raffaelerasini/stand-generator/README.md

# Supporti inclinabili low profile

Un solo generatore (`stand.py`) per tre strumenti. Tutti hanno la stessa struttura a sdraio, ma con la **cerniera a pochi millimetri dal tavolo**:

- 2 fianchi, ognuno fatto di **base** con tacche a gradini, **ripiano** incernierato con bordino anteriore e **asta** che ruota in una forcella sul retro del ripiano;
- 2 traverse (una al centro, una dietro) che passano in tunnel nelle pareti della base e si fissano con una vite nell'aletta interna; le asole regolano la distanza tra i fianchi.

Davanti non c'è nessun blocco: la cerniera ha tutto lo spazio per ruotare.

| Cartella | Strumento | Angoli | Piano d'appoggio davanti | Profondità base | Filamento |
|---|---|---|---|---|---|
| `virus_ti/` | Access Virus TI/TI2 Desktop, 470 × 188 × 81 mm, 3,5 kg | 15° 25° 35° 45° | **22 mm** (bordino +30) | **190 mm** | ~460 g |
| `tracker_plus/` | Polyend Tracker+, 282 × 207 × 33 mm, 1,2 kg | 5° 10° 15° | **18 mm** (bordino +10) | 228 mm | ~255 g |
| `launchpad_pro/` | Novation Launchpad Pro MK3, 268 × 268 × 18 mm, ~1 kg | 5° 10° 15° | **18 mm** (bordino +8) | 228 mm | ~255 g |

Per confronto, nella prima versione (`../virus_stand/`) il piano d'appoggio era a 66 mm.
In ogni configurazione ho verificato che non ci siano collisioni tra base, ripiano, asta, traverse, teste delle viti e strumento (booleane 3D), e che ogni pezzo sia un corpo unico.
La traversa centrale si posiziona da sola: la vecchia posizione (x = 40–45) toccava il ripiano all'angolo minimo, e il controllo vecchio non lo vedeva.
A 45° il bordo anteriore-alto del Virus sporge ~60 mm davanti alla base (in aria): è normale, la base resta entro i 190 mm.

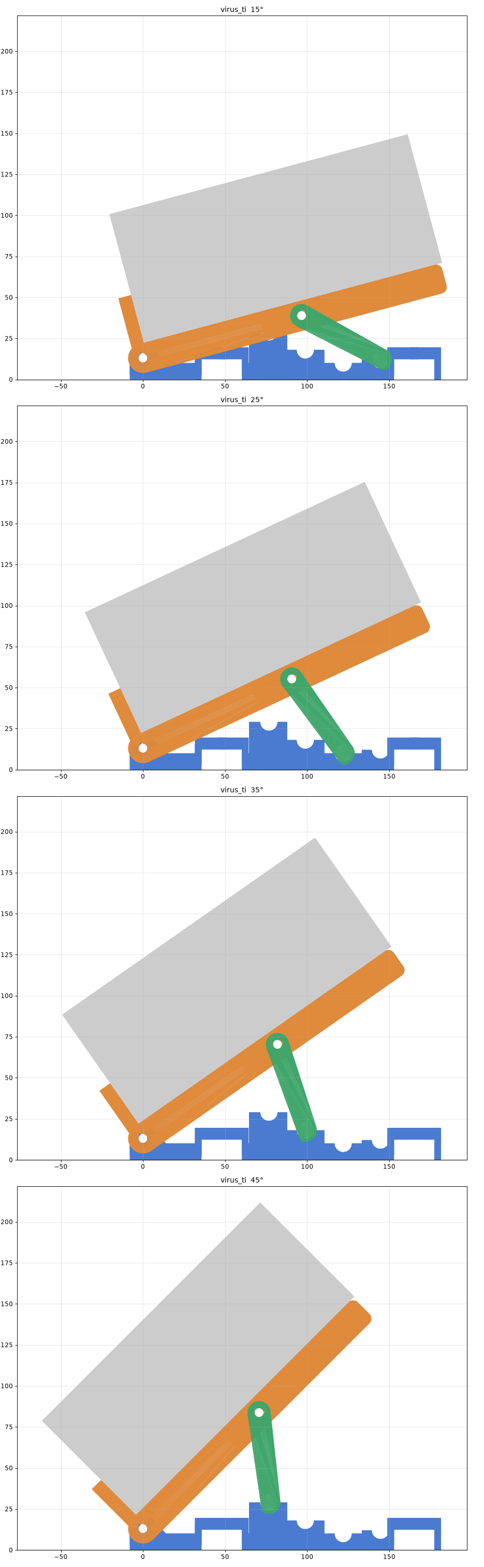
[picture p1: virus_ti/preview/vista_laterale.png]
virus


## Pezzi (`<strumento>/stl/`, già orientati per la stampa, senza supporti)

| | Virus TI | Tracker+ / Launchpad |
|---|---|---|
| `base_x2` | 190 × 72 × 29 | 228 × 72 × 18 |
| `deck_x2` (ripiano) | 199 × 27 × 34 | 197 × 27 × 22–24 |
| `prop_x2` (asta) | 69 × 41 × 14 | 47 × 40 × 12 |
| traverse | `crossbar_A_x2` + `crossbar_B_x2` (244 mm, unite a mezzo legno) | `crossbar_x2` (248 mm, in un pezzo) |

Le traverse sono lunghe 244–248 mm: nel piatto da 256 della A1 entrano di poco; se lo slicer si lamenta, ruotale in diagonale.
Stampa consigliata: PETG, 4 pareti, gyroid 30–40 %.

## Ferramenta

Le viti di cerniera e perno possono essere a brugola (DIN 912) o a testa esagonale (DIN 933): ho verificato che le teste non tocchino le pareti a nessun angolo.

**Virus TI**

- 2 viti M5×50 per la cerniera (l'autobloccante va nella sede esagonale della parete)
- 2 viti M5×40 per il perno dell'asta
- 4 dadi autobloccanti M5 e 6 rondelle
- 4 viti M5×20, 4 dadi e 4 rondelle per fissare le traverse (nell'aletta interna delle basi)
- 6 viti M5×16 e 6 dadi per la giunzione delle traverse (3 per traversa)

**Tracker+ e Launchpad Pro (per ciascuno)**

- 2 viti M5×50 per la cerniera (l'autobloccante va nella sede esagonale della parete)
- 2 viti M5×40 per il perno dell'asta
- 4 dadi autobloccanti M5 e 6 rondelle
- 4 viti M5×16, 4 dadi e 4 rondelle per le traverse (nell'aletta interna delle basi)

## Montaggio

Ogni cartella ha `istruzioni.pdf`: istruzioni illustrate stile IKEA (pezzi, ferramenta in scala 1:1, passi esplosi, cambio angolo). In breve:

1. **Traverse.** Sul Virus, unisci le metà A e B nella zona a mezzo legno: i dadi vanno nelle sedi esagonali sotto A, le teste delle viti nelle lamature sopra B.
2. **Basi.** Infila le due traverse nei tunnel delle basi (quello al centro e quello dietro). Le alette con il foro rivolte verso l'interno ricevono la vite: dado nel canale sotto la traversa, vite con rondella dall'alto. Le asole regolano la distanza tra i fianchi:
   - Virus: 330–390 mm, consigliata ~370;
   - Tracker+: 170–200 mm, consigliata ~190;
   - Launchpad Pro: 160–200 mm, consigliata ~180.
3. **Ripiano.** Infilalo tra le pareti della base, davanti, e fissalo con la vite della cerniera (rondella sotto la testa) e il dado autobloccante, che va incassato nella sede esagonale sul lato esterno della parete.
4. **Asta.** Inseriscila nella forcella sul retro del ripiano e fissala con il perno. Le "orecchie" del piede si appoggiano nelle tacche delle pareti.
5. **Cambio angolo.** Solleva il retro dello strumento, sposta il piede nella tacca voluta e riabbassa. Le tacche sono a gradini: la più bassa e più indietro è l'angolo minimo, la più alta e più avanti è il massimo.

## Rigenerare / modificare

Il motore è il pacchetto `standgen/`, lo stesso che usa il sito:

| File | Cosa fa |
|---|---|
| `model.py` | parametri (default leggero/pesante, `PRESETS`) e geometria, nella classe `Stand` |
| `tune.py` | calcolo automatico di tacche, perno e lunghezza dell'asta (minimizza la profondità) |
| `checks.py` | verifica: collisioni a ogni angolo (anche ripiano/asta contro le traverse), pezzi interi, piatto, viti, tacche, stabilità, scorta |
| `hardware.py` | catalogo della viteria standard (`../VITERIA_STANDARD.md`) e scelta delle lunghezze |
| `render.py` | anteprime PNG e assemblato 3D colorato (GLB) |
| `drawing.py` | disegni al tratto: rasterizzatore z-buffer in numpy, contorni senza linee nascoste, viteria 3D |
| `blueprint.py` | per il sito: disegni chiari su fondo trasparente e mesh con spigoli vivi per il visore |
| `ikea.py` | `istruzioni.pdf`: copertina, pezzi, ferramenta 1:1, passi esplosi con dettagli, cambio angolo |
| `pipeline.py` | `generate(parametri, cartella)`: STL, anteprime, `ferramenta.csv`, `verifica.md`, `montaggio.md`, `parametri.json`, zip |

```
python stand.py                          # tutti i profili (o: python stand.py virus_ti)
python stand.py --params mio.json        # strumento nuovo: le tacche si calcolano se mancano
python stand.py --no-pdf                 # senza istruzioni illustrate (~15-20 s per strumento)
python render.py                         # solo anteprime
python tests/test_engine.py              # test
```

Un file di parametri minimo per uno strumento nuovo:

```json
{"DEV_W": 378, "DEV_D": 293, "DEV_H": 41, "DEV_KG": 3.2, "ANGLES": [10, 20, 30], "MAX_DEPTH": 200}
```

Da 2 kg in su si usano automaticamente i pezzi robusti (come il Virus).

`PRESETS` contiene anche i desktop synth, le groovebox e i controller più diffusi (scelti dalle vetrine Thomann e
dalle guide 2026), con le misure delle schede dei produttori: Korg volca, Roland AIRA Compact, Behringer TD-3,
Model D e UB-Xa D, Moog Mother-32, Waldorf Blofeld, Korg minilogue xd module; Elektron Digitakt II / Digitone II /
Syntakt, Roland TR-8S, SP-404MKII e MC-707, Akai MPC One+ e Live III, Novation Circuit, Teenage Engineering EP-133,
Maschine+; Launchpad X e Mini MK3, Launch Control XL 3, Akai APC40 MKII, APC mini MK2 e MPD218, Maschine Mikro MK3
e MK3, Ableton Push 3, Arturia BeatStep Pro. I synth sono a 10°, 20° e 30°, controller e groovebox a 5°, 10° e 15°.

Ci sono poi i computer Commodore con tastiera integrata: VIC-20, C64 (breadbin),
C64C, C16, Plus/4, C128, Amiga 500 / 500 Plus, Amiga 600, Amiga 1200, tutti a 5°, 10° e 15°. Le misure vengono da
c64-wiki.de, Wikipedia e dalle brochure Commodore e differiscono di qualche millimetro tra le fonti: prima di
stampare misura il tuo. Il peso di C16 e Plus/4 non si trova ed è stimato per eccesso. Gli Amiga con tastiera
separata (1000, 2000, 3000, 4000) non ci sono: non hanno una tastiera da inclinare.

Altri home computer, sempre a 5°, 10° e 15°: Sinclair ZX Spectrum 16K/48K, Spectrum+ / 128, +2 / +3; Atari 800,
600XL, 800XL, 520ST (cassa corta), 520/1040 STF e STE; Amstrad CPC 464, 664, 6128; Acorn BBC Micro Model B;
Texas Instruments TI-99/4A. Le fonti sono musei e archivi di appassionati (vedi i commenti in `model.py`); le misure
più incerte sono quelle dello Spectrum +2 / +3. Peso stimato per eccesso per Spectrum+ e CPC 6128.

## Sito web: STAND

Interfaccia in HTML, CSS e JavaScript semplici (`static/`, nessun framework né build) sopra un'API FastAPI (`app.py`).
Stile "blueprint scuro": fondo grafite millimetrato, tratto chiaro, un solo accento arancio; caratteri Space Grotesk,
Inter e JetBrains Mono da Google Fonts.

- **Modello:** visore 3D fatto in casa in WebGL2 (ortografico come un disegno tecnico: trascina per ruotare, rotella
  per lo zoom, tasto destro per spostare, doppio clic per tornare alla vista iniziale) oppure profilo per ogni angolo;
  riepilogo con misure, pezzi, ferramenta e download.
- **Pezzi e ferramenta:** disegni dei pezzi, viti in proporzione, quantità e scorta.
- **Montaggio:** le pagine di `istruzioni.pdf` con testo e ferramenta di ogni passo (il PDF si crea al primo clic, ~20 s).
- **Verifica:** tutti i controlli, raggruppati.

Ogni risultato ha un indirizzo (`#/<chiave>/<scheda>`) che si può riaprire finché resta in cache
(`DATA_DIR/cache`, ultime `CACHE_MAX` generazioni).

| API | |
|---|---|
| `GET /api/presets` | profili pronti |
| `POST /api/generate` | genera (o riprende dalla cache): `{key}` oppure un lavoro `{id, state, progress, stage}` |
| `GET /api/jobs/{id}` | avanzamento del lavoro |
| `GET /api/result/{key}` | riepilogo, pezzi, ferramenta, controlli, guida al montaggio |
| `POST /api/pdf/{key}` | crea le istruzioni illustrate |
| `GET /api/mesh/{key}/{angolo}.json` | mesh per il visore (vertici, triangoli, spigoli vivi) |
| `GET /api/draw/{key}/{hero,side_<angolo>,part_<pezzo>}.png` | disegni blueprint, creati alla prima richiesta |
| `GET /files/{key}/…` | STL, zip, CSV, PDF |

```
pip install -r requirements.txt && python app.py      # http://localhost:7860
docker compose up --build                             # idem, in container (porta dal file override)
```

**Coolify:** nuova risorsa *Docker Compose* dal repository (cartella base `/`, file `docker-compose.yml`);
assegna il dominio al servizio `stands` (porta 7860). Variabili facoltative: `APP_PASSWORD` (+ `APP_USER`, default
`admin`) per proteggere il sito, `CONCURRENCY` (generazioni in parallelo, default 2), `CACHE_MAX`.
I risultati stanno nel volume `stands-data`. `docker-compose.override.yml` serve solo in locale (pubblica la porta).
