raffaelerasini/stand-generator/tracker_plus/istruzioni.pdf

# Supporto inclinabile

## Polyend Tracker+

5° 10° 15°

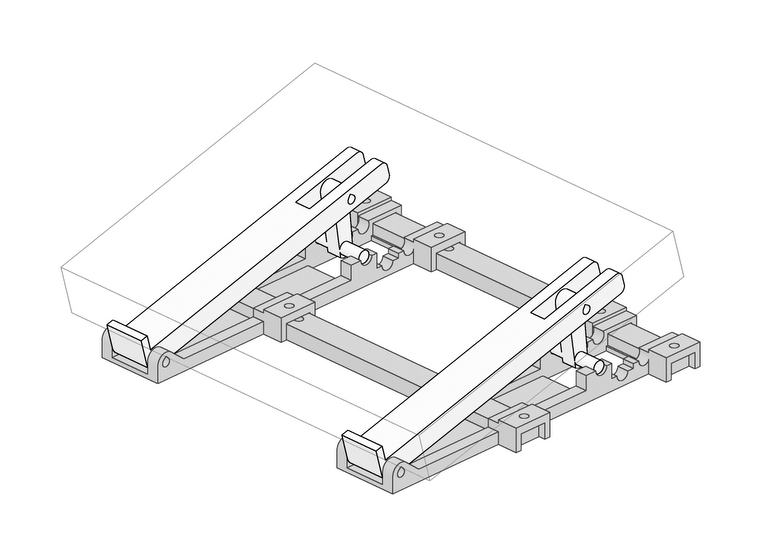
[picture p9: figure]

# Ti servono

### - chiave a brugola 4 mm

### - chiave fissa o a tubo da 8 mm

Stampa i pezzi in PETG, 4 pareti, riempimento gyroid 30–40 %, senza supporti.

Le viti sono tutte M5 inox della scorta standard.

# Pezzi da stampare

2×

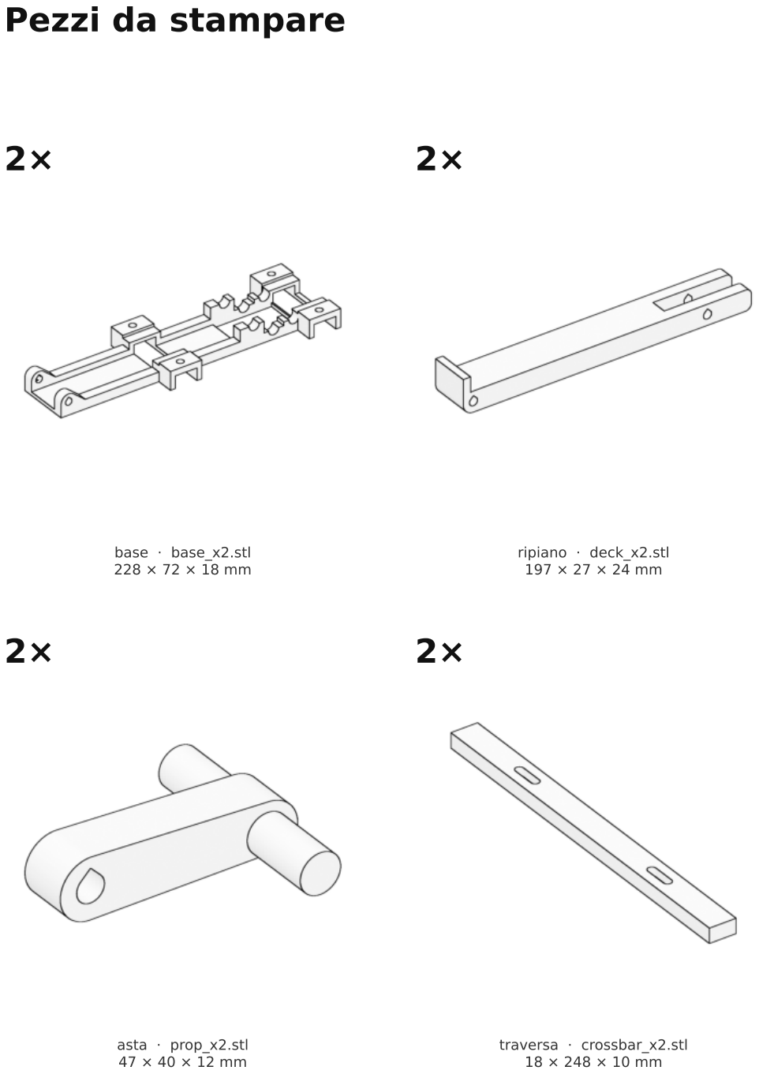
[picture p10: page 2]

base · base_x2.stl
228 × 72 × 18 mm

2×

ripiano · deck_x2.stl
197 × 27 × 24 mm
2×

asta · prop_x2.stl
47 × 40 × 12 mm

2×

traversa · crossbar_x2.stl 18 × 248 × 10 mm

# Ferramenta

Scala 1:1: stampa al 100 % e appoggia le viti sul disegno per riconoscerle.

2× | Vite M5×50 testa esagonale (DIN 933)
| cerniera
4× | Dado M5 autobloccante
| cerniera, perno asta
2× | Vite M5×40 testa esagonale (DIN 933)
| perno asta
10× | Rondella M5 5×10
| cerniera, perno asta, traverse
4× | Vite M5×16 brugola (DIN 912)
| traverse
4× | Dado M5
| traverse

controllo scala: 100 mm

1

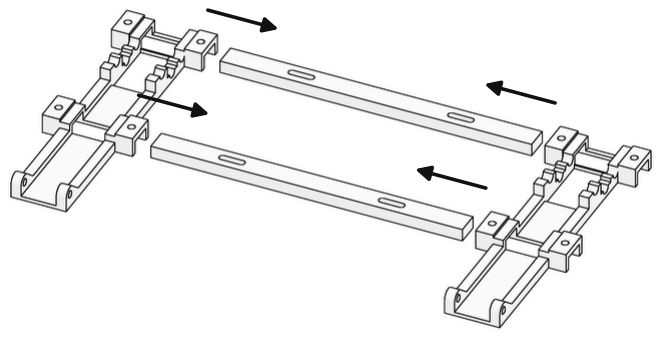
[picture p11: figure]

Infila le traverse nei tunnel delle due basi, una davanti e una dietro (sono uguali). Le alette con il foro restano

verso l'interno.

2

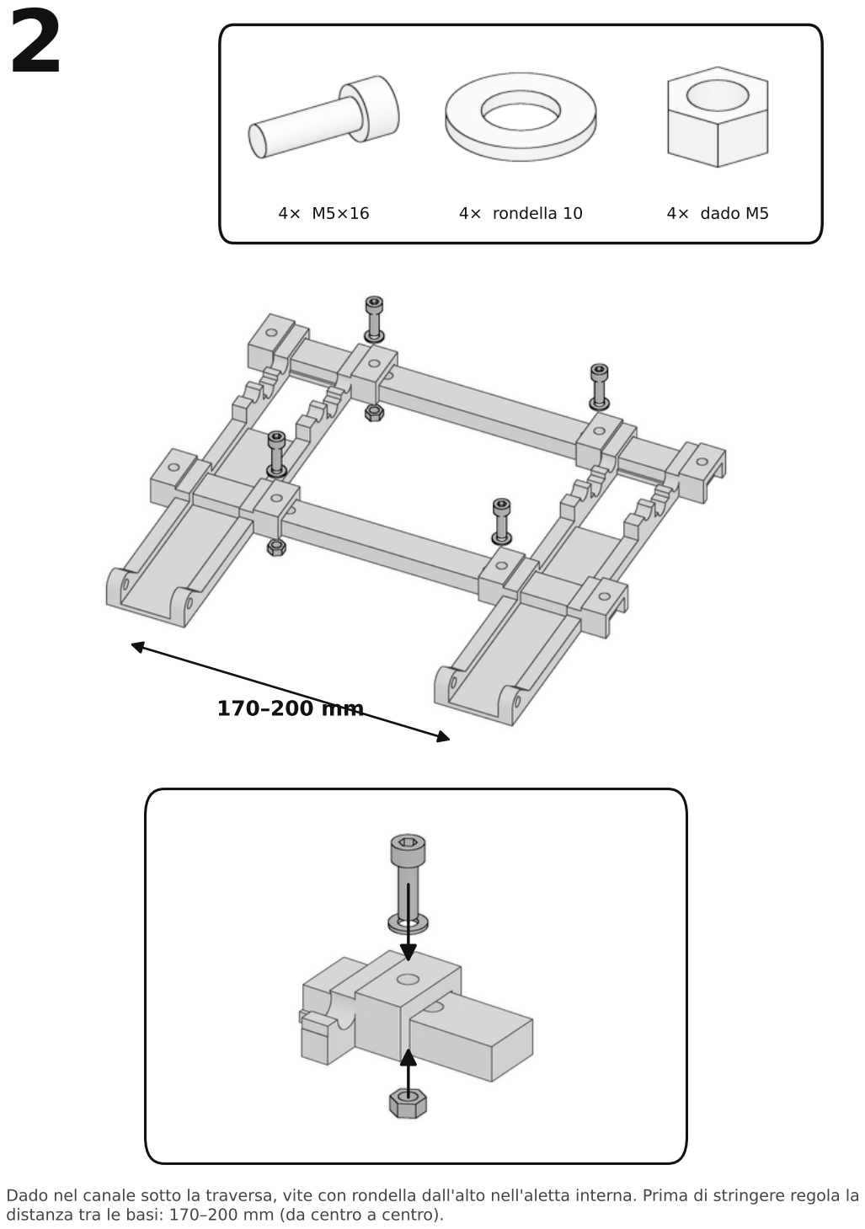
[picture p12: page 5]

170–200 mm

Dado nel canale sotto la traversa, vite con rondella dall'alto nell'aletta interna. Prima di stringere regola la distanza tra le basi: 170–200 mm (da centro a centro).

4× M5×16 | 4× rondella 10 | 4× dado M5

3

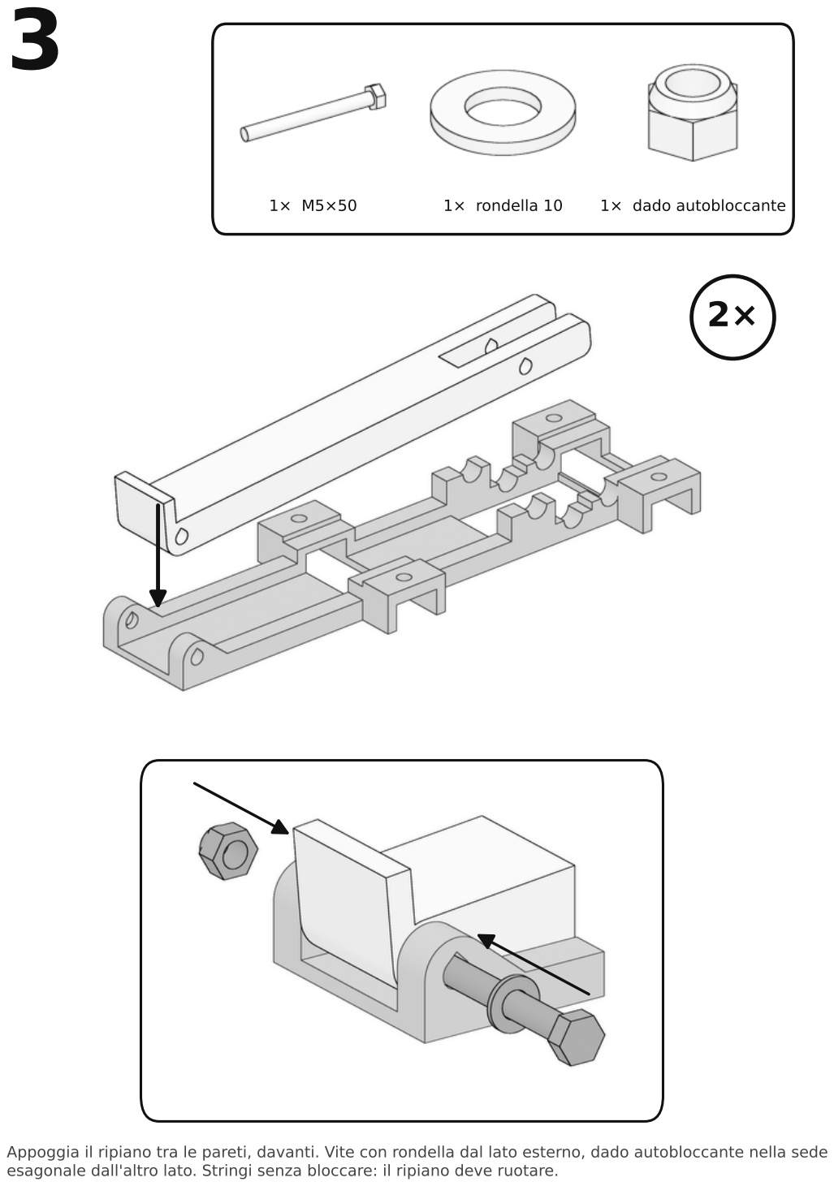
[picture p13: page 6]

Appoggia il ripiano tra le pareti, davanti. Vite con rondella dal lato esterno, dado autobloccante nella sede esagonale dall'altro lato. Stringi senza bloccare: il ripiano deve ruotare.

1× M5×50 | 1× rondella 10 | 1× dado autobloccante
2×

4

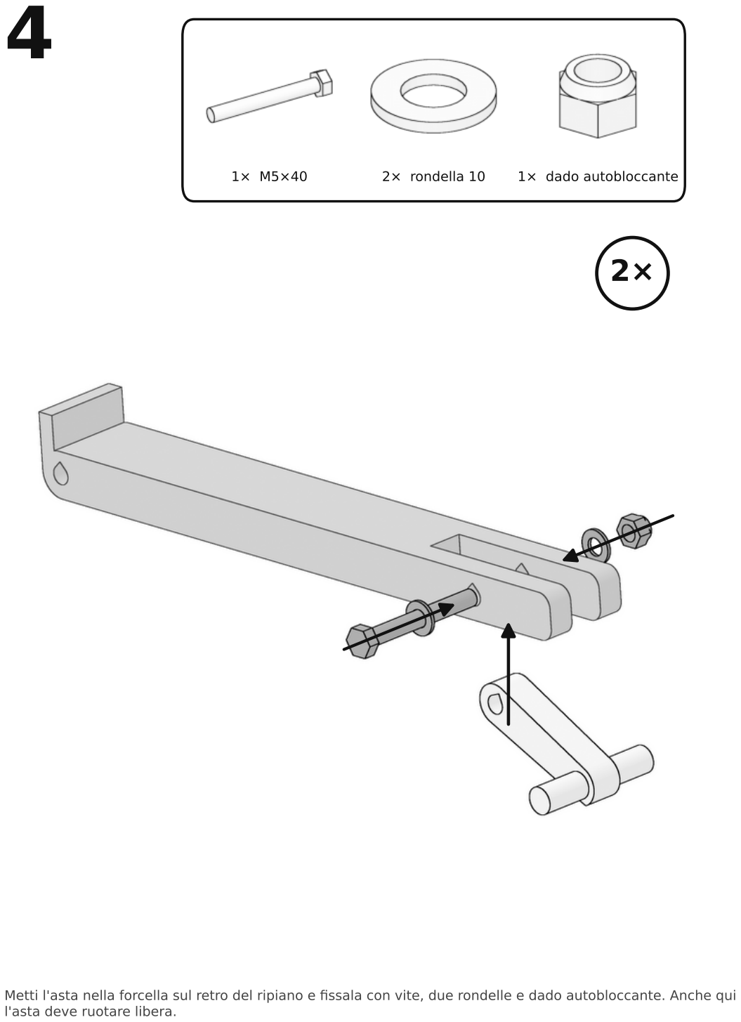
[picture p14: page 7]

Metti l'asta nella forcella sul retro del ripiano e fissala con vite, due rondelle e dado autobloccante. Anche qui

l'asta deve ruotare libera.

1× M5×40 | 2× rondella 10 | 1× dado autobloccante
2×

5

5°

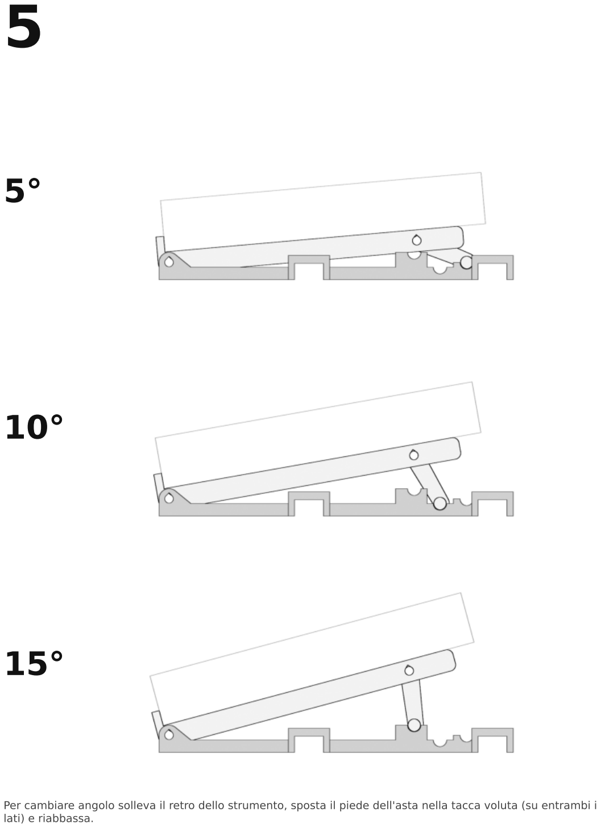
[picture p15: page 8]

Per cambiare angolo solleva il retro dello strumento, sposta il piede dell'asta nella tacca voluta (su entrambi i lati) e riabbassa.

10°

15°
