raffaelerasini/stand-generator/virus_ti/istruzioni.pdf

# Supporto inclinabile

## Access Virus TI/TI2 Desktop

15° 25° 35° 45°

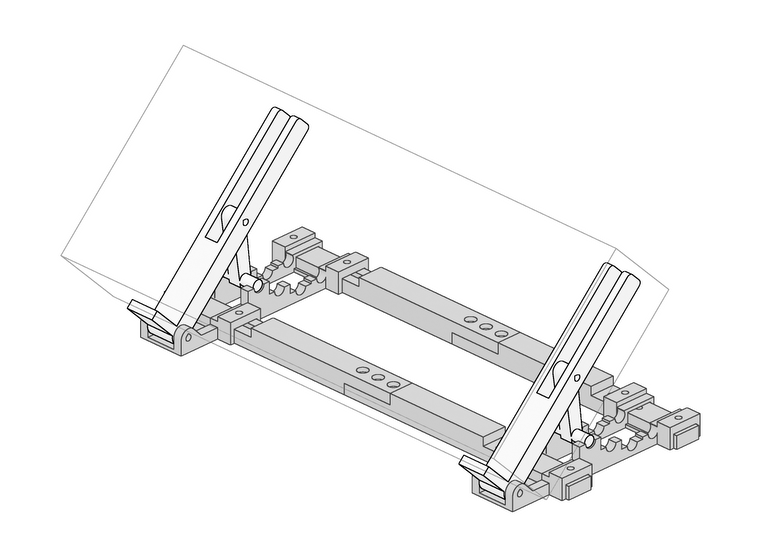
[picture p16: figure]

## Ti servono

### - chiave a brugola 4 mm

### - chiave fissa o a tubo da 8 mm

Stampa i pezzi in PETG, 4 pareti, riempimento gyroid 30–40 %, senza supporti.

Le viti sono tutte M5 inox della scorta standard.

# Pezzi da stampare

2×

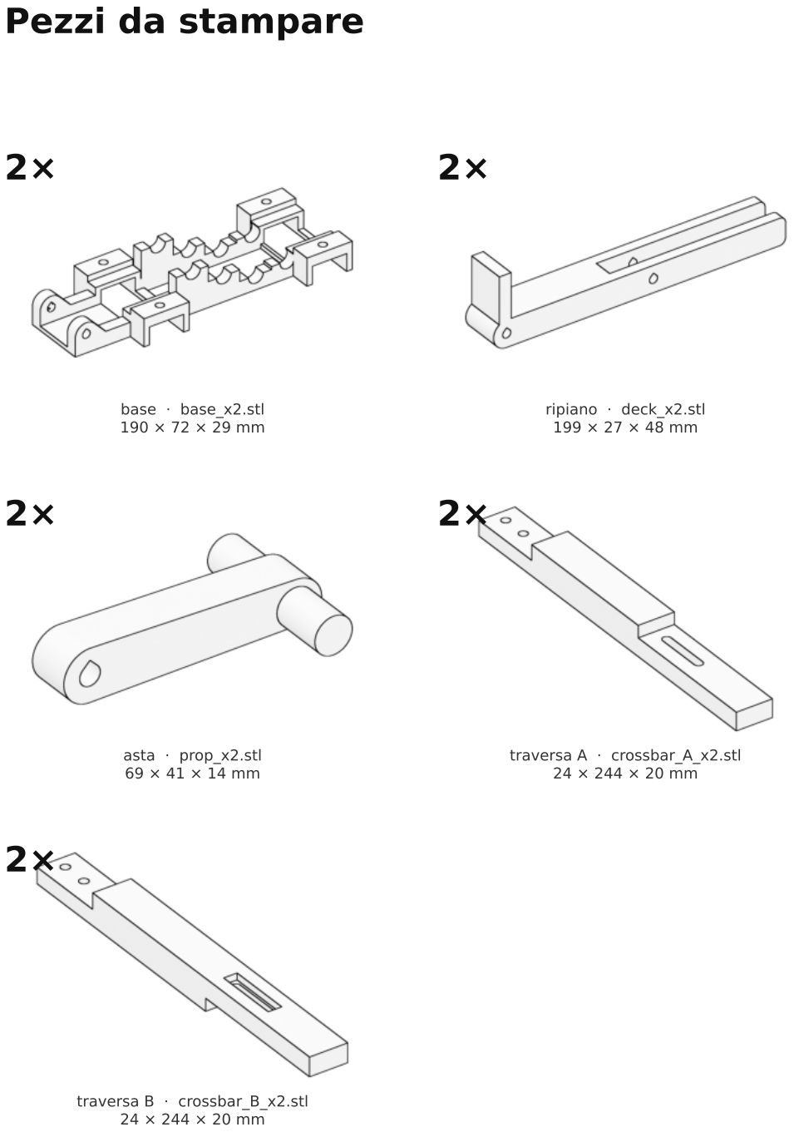
[picture p17: page 2]

base · base_x2.stl
190 × 72 × 29 mm

2×

ripiano · deck_x2.stl
199 × 27 × 48 mm

2×

asta · prop_x2.stl
69 × 41 × 14 mm

2×

traversa A · crossbar_A_x2.stl 24 × 244 × 20 mm

2×

traversa B · crossbar_B_x2.stl 24 × 244 × 20 mm

# Ferramenta

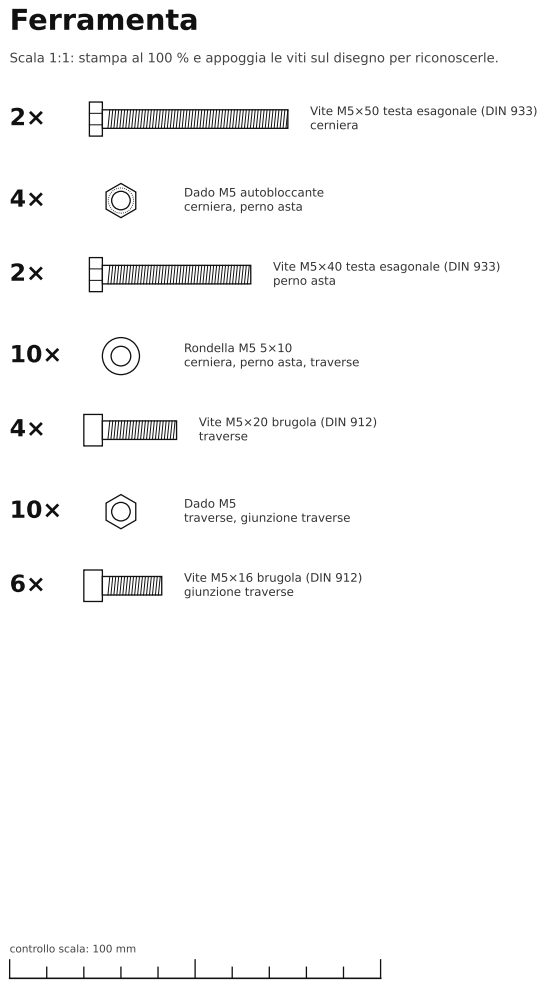
[picture p18: page 3]
Vite M5×50 testa esagonale (DIN 933); cerniera; Dado M5 autobloccante; Vite M5×40 testa esagonale (DIN 933); perno asta; Rondella M5 5×10; Vite M5×20 brugola (DIN 912); traverse; Dado M5; Vite M5×16 brugola (DIN 912); giunzione traverse

Scala 1:1: stampa al 100 % e appoggia le viti sul disegno per riconoscerle.

cerniera, perno asta

cerniera, perno asta, traverse

traverse, giunzione traverse

controllo scala: 100 mm

1

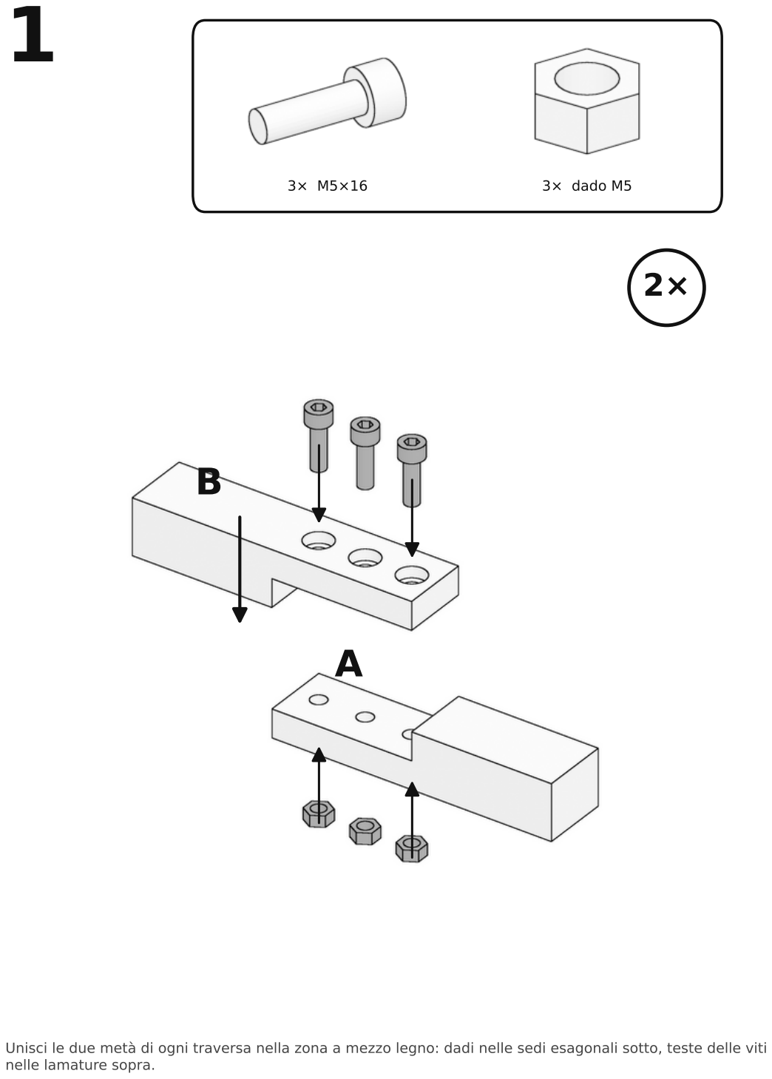
[picture p19: page 4]

A

B

Unisci le due metà di ogni traversa nella zona a mezzo legno: dadi nelle sedi esagonali sotto, teste delle viti nelle lamature sopra.

3× M5×16 | 3× dado M5

2×

2

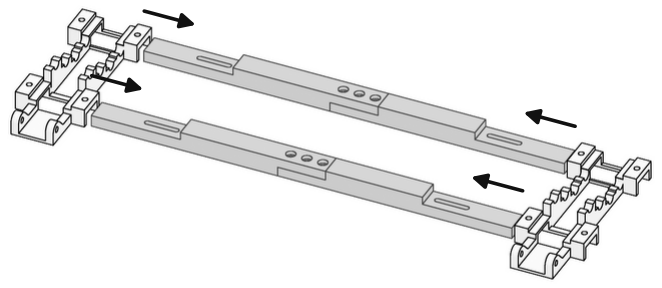
[picture p20: figure]

Infila le traverse nei tunnel delle due basi, una davanti e una dietro (sono uguali). Le alette con il foro restano

verso l'interno.

3

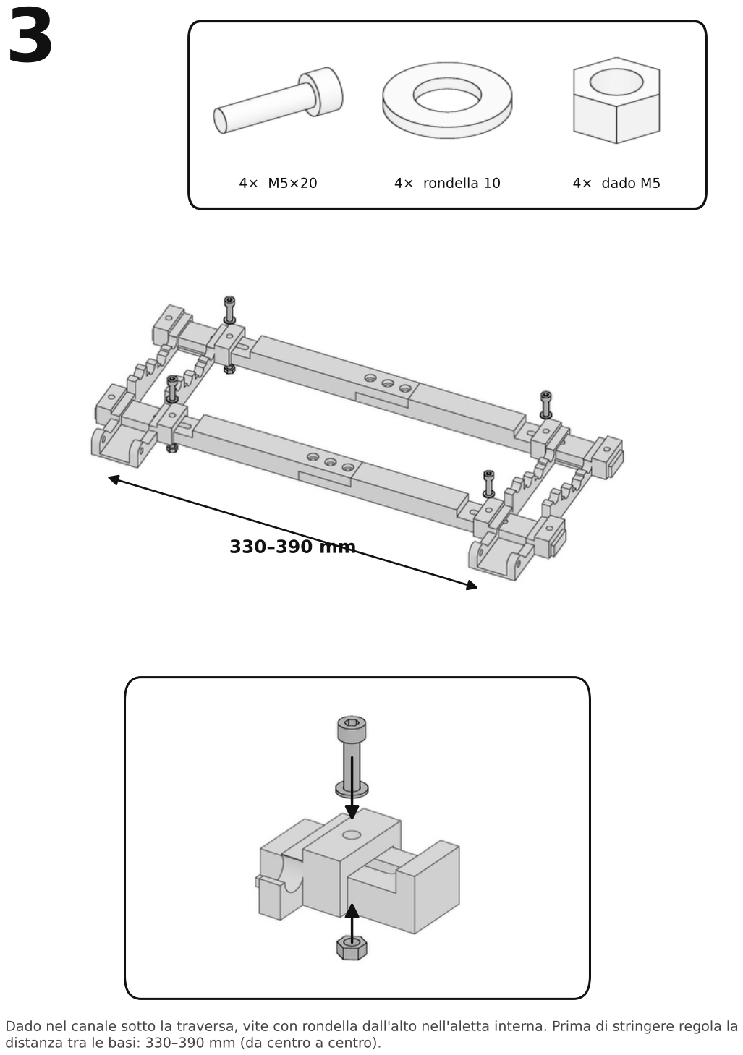
[picture p21: page 6]

330–390 mm

Dado nel canale sotto la traversa, vite con rondella dall'alto nell'aletta interna. Prima di stringere regola la distanza tra le basi: 330–390 mm (da centro a centro).

4× M5×20 | 4× rondella 10 | 4× dado M5

4

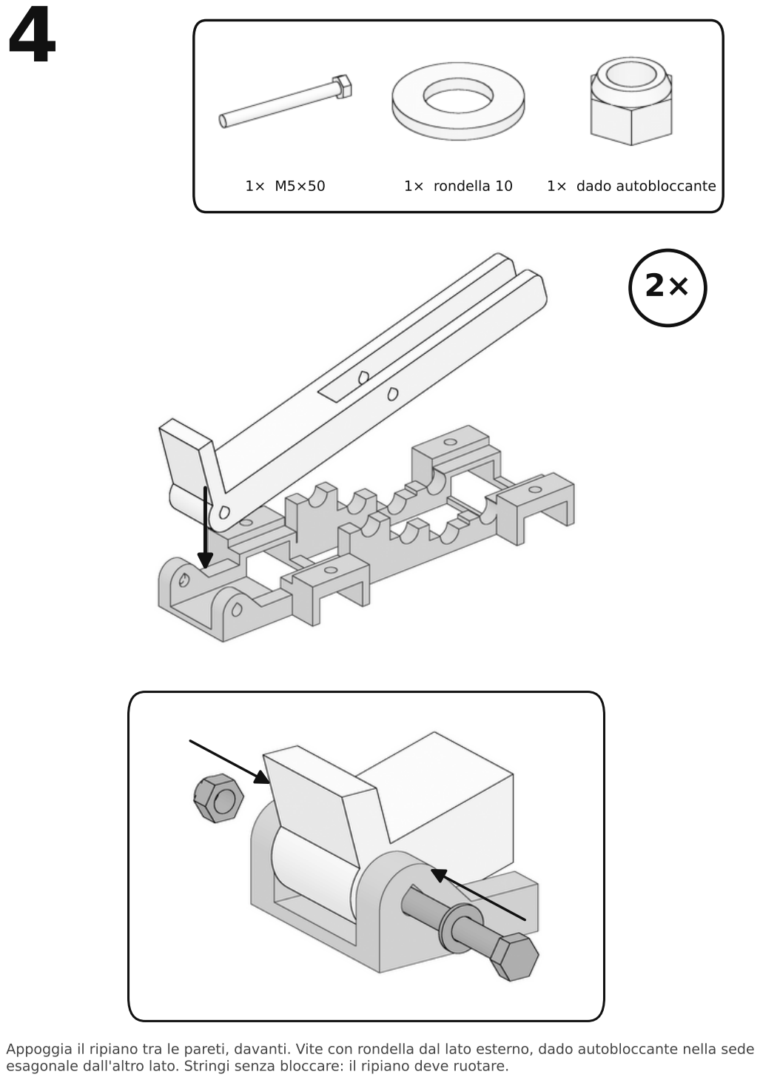
[picture p22: page 7]

Appoggia il ripiano tra le pareti, davanti. Vite con rondella dal lato esterno, dado autobloccante nella sede esagonale dall'altro lato. Stringi senza bloccare: il ripiano deve ruotare.

1× M5×50 | 1× rondella 10 | 1× dado autobloccante

2×

5

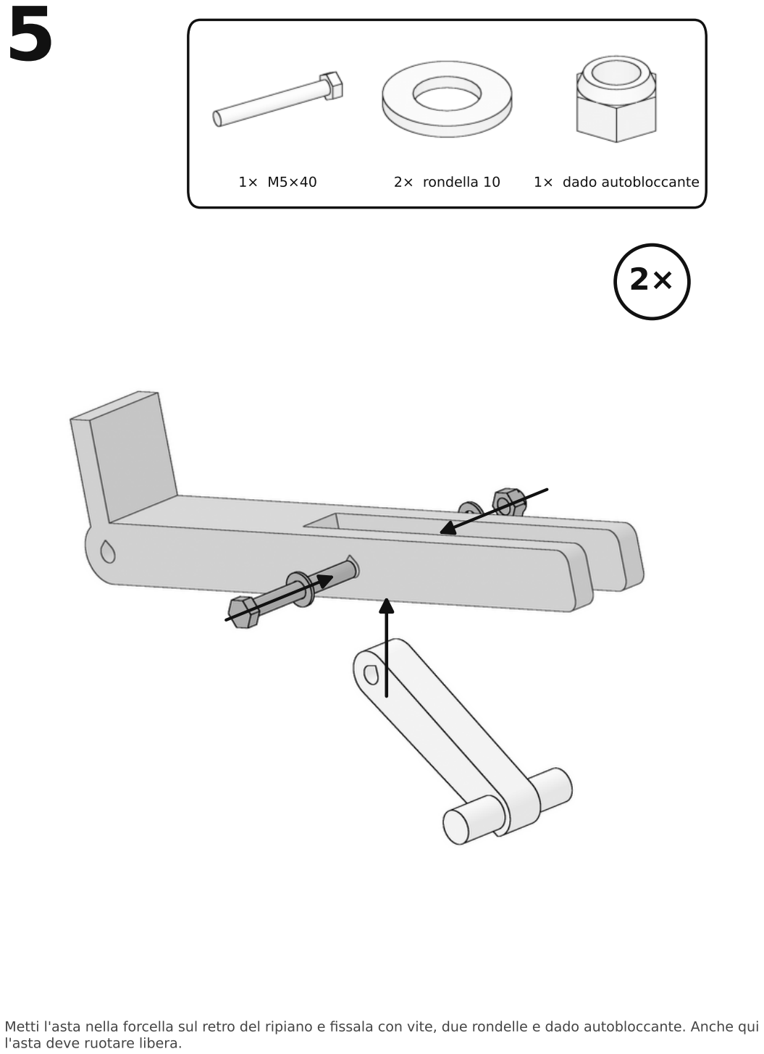
[picture p23: page 8]

Metti l'asta nella forcella sul retro del ripiano e fissala con vite, due rondelle e dado autobloccante. Anche qui

l'asta deve ruotare libera.

1× M5×40 | 2× rondella 10 | 1× dado autobloccante

2×

6

15°

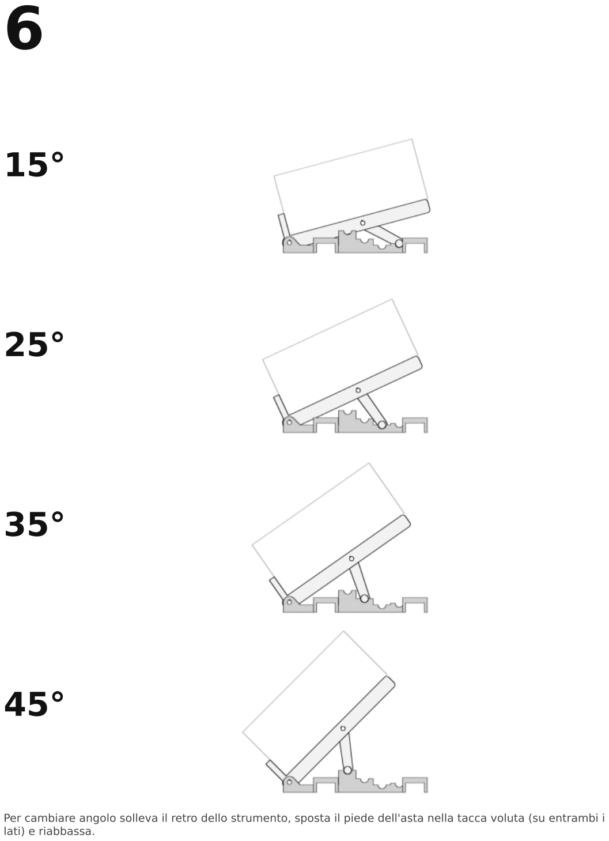
[picture p24: page 9]

Per cambiare angolo solleva il retro dello strumento, sposta il piede dell'asta nella tacca voluta (su entrambi i lati) e riabbassa.

25°

35°

45°
