raffaelerasini/stand-generator/launchpad_pro/preview/vista_laterale.png

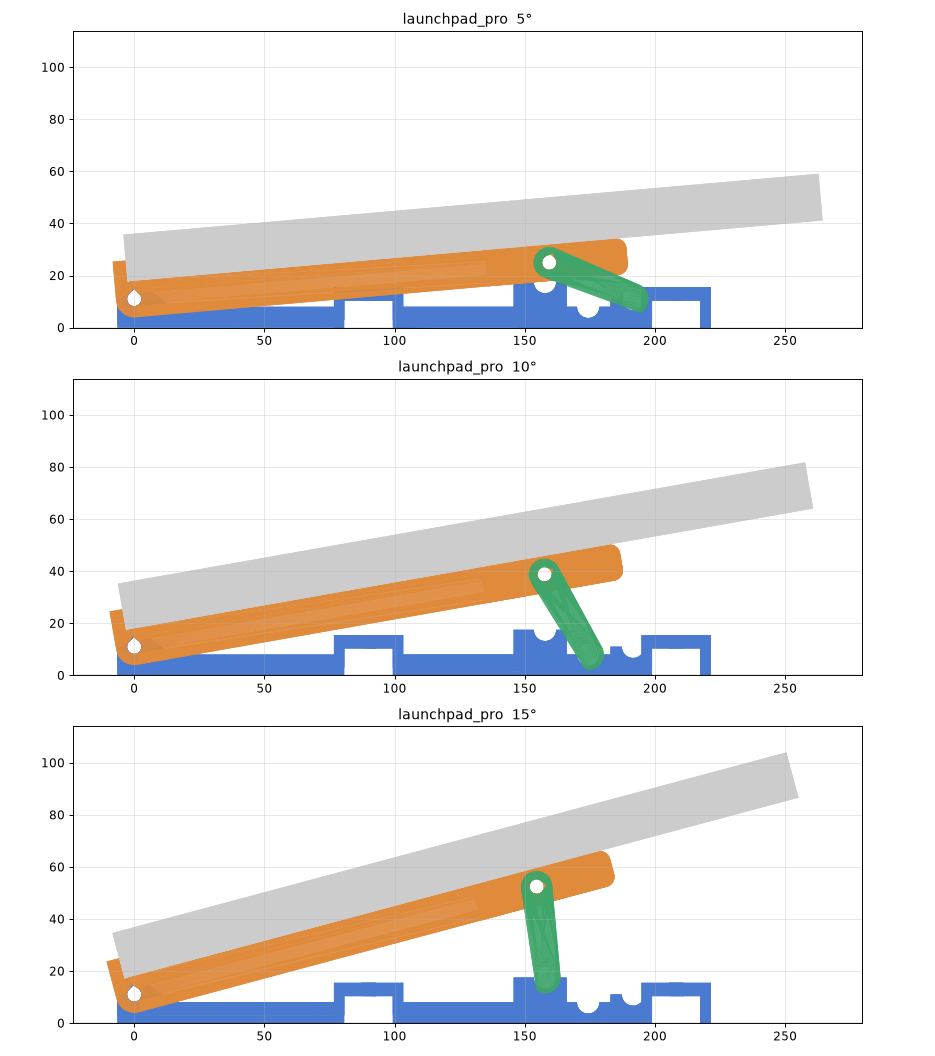
launchpad_pro/preview/vista_laterale.png
