raffaelerasini/stand-generator/tracker_plus/preview/vista_laterale.png

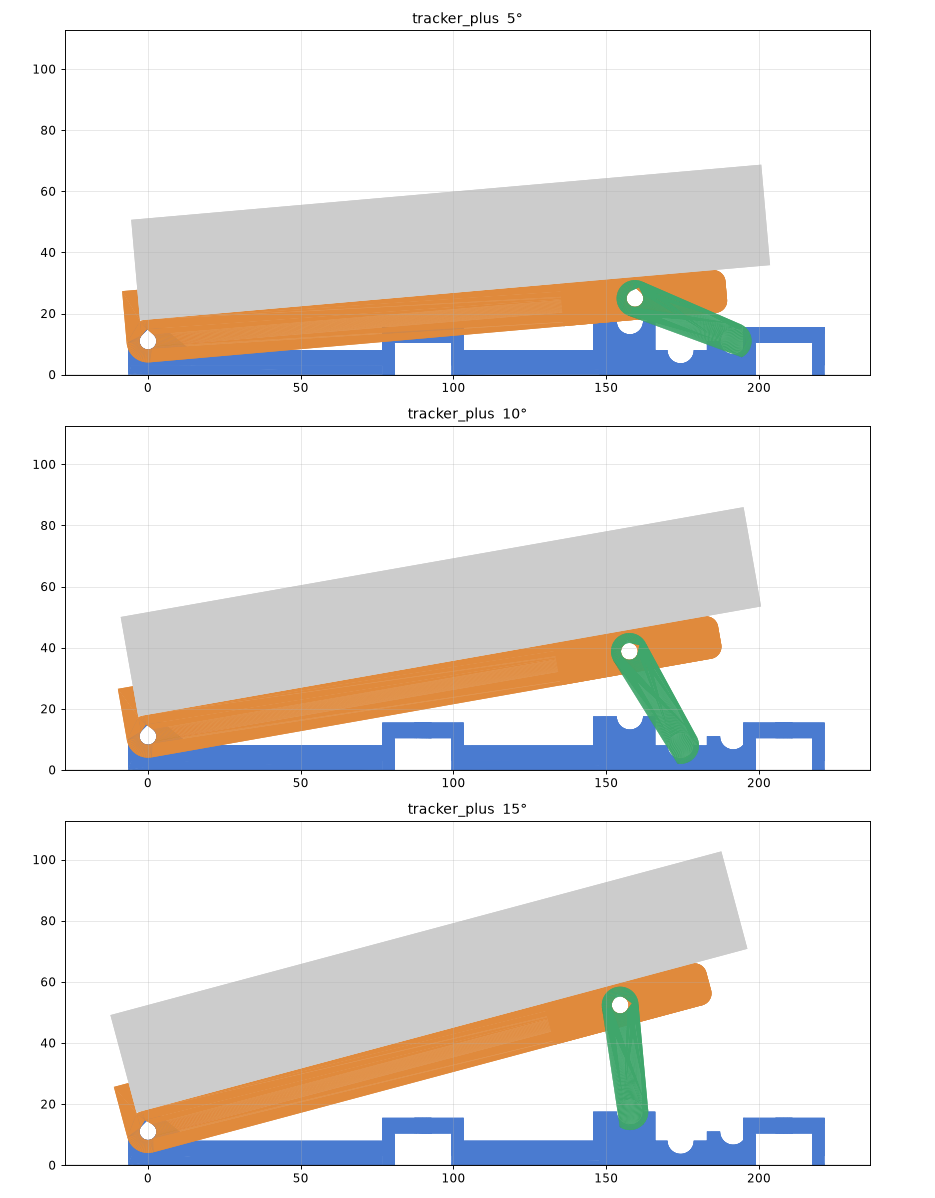
tracker_plus/preview/vista_laterale.png
