raffaelerasini/stand-generator/launchpad_pro/ferramenta.csv

codice | descrizione | quantita | scorta | uso
M5x50TE | Vite M5×50 testa esagonale (DIN 933) | 2 | 12 | cerniera
NYLOC_M5 | Dado M5 autobloccante | 4 | 30 | cerniera, perno asta
M5x40TE | Vite M5×40 testa esagonale (DIN 933) | 2 | 12 | perno asta
RONDELLA_5x10 | Rondella M5 5×10 | 10 | 100 | cerniera, perno asta, traverse
M5x16 | Vite M5×16 brugola (DIN 912) | 4 | 30 | traverse
DADO_M5 | Dado M5 | 4 | 60 | traverse
