raffaelerasini/stand-generator/launchpad_pro/stl/base_x2.stl

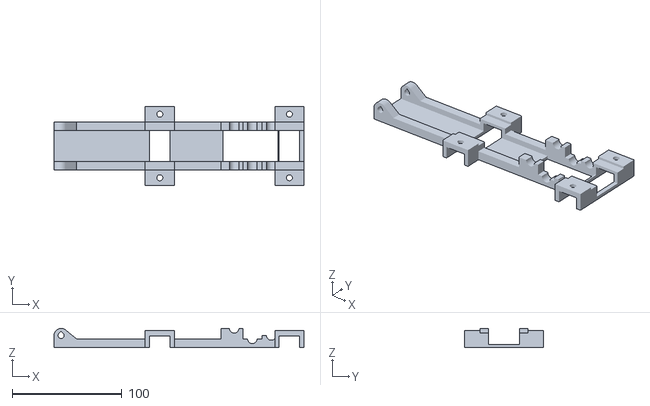
[picture p27: CAD file, 2026-11-08]
launchpad_pro/stl/base_x2.stl
228.0 x 72.0 x 17.5
