raffaelerasini/stand-generator/virus_ti/stl/base_x2.stl

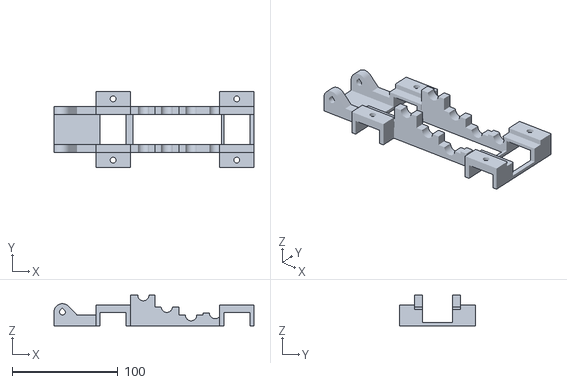
[picture p28: CAD file, 2026-11-08]
virus_ti/stl/base_x2.stl
189.5 x 72.0 x 29.0
