raffaelerasini/stand-generator/launchpad_pro/stl/deck_x2.stl

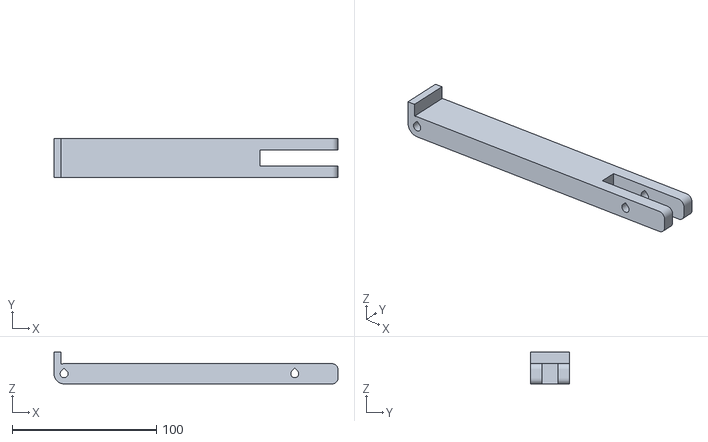
[picture p29: CAD file, 2026-11-08]
launchpad_pro/stl/deck_x2.stl
197.0 x 27.0 x 22.0
