raffaelerasini/stand-generator/tracker_plus/stl/crossbar_x2.stl

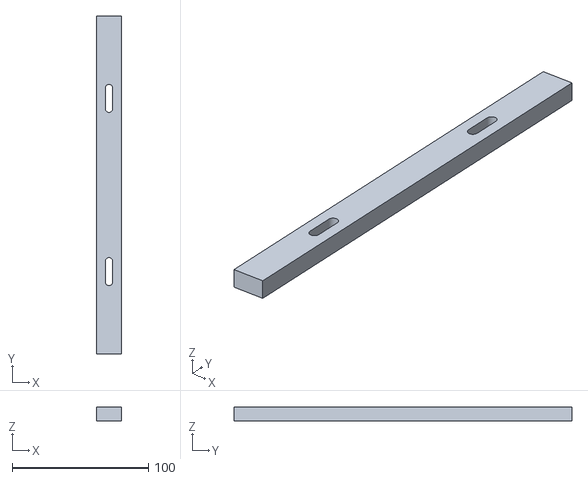
[picture p30: CAD file, 2026-11-08]
tracker_plus/stl/crossbar_x2.stl
18.0 x 248.0 x 10.0
