raffaelerasini/stand-generator/virus_ti/stl/deck_x2.stl

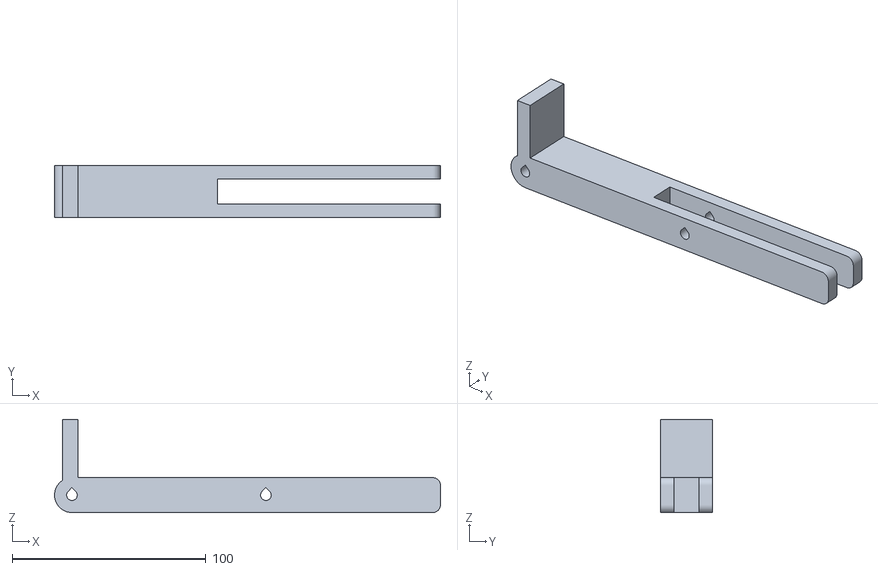
[picture p31: CAD file, 2026-11-08]
virus_ti/stl/deck_x2.stl
199.0 x 27.0 x 48.0
