raffaelerasini/stand-generator/launchpad_pro/stl/prop_x2.stl

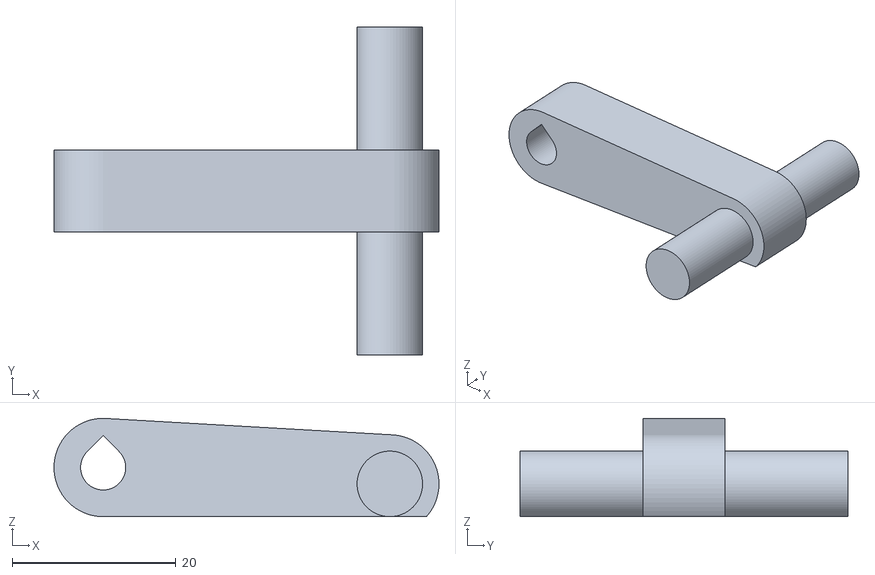
[picture p32: CAD file, 2026-11-08]
launchpad_pro/stl/prop_x2.stl
47.0 x 40.0 x 12.0
