raffaelerasini/stand-generator/tracker_plus/stl/deck_x2.stl

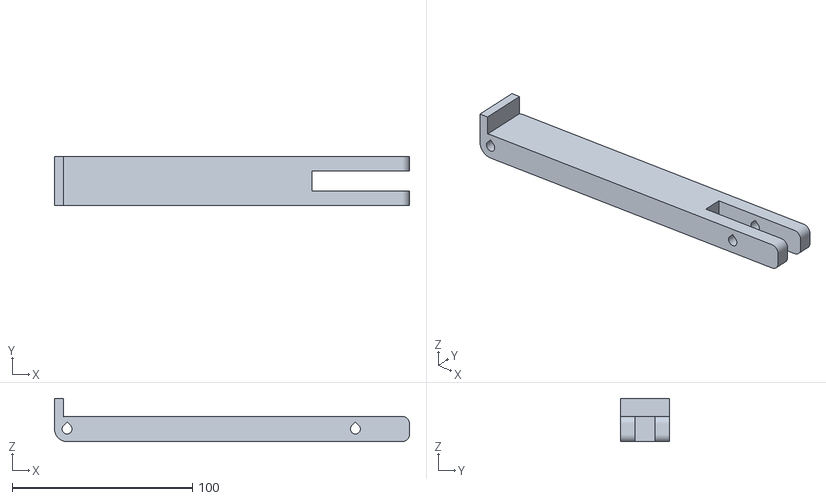
[picture p33: CAD file, 2026-11-08]
tracker_plus/stl/deck_x2.stl
197.0 x 27.0 x 24.0
