raffaelerasini/stand-generator/virus_ti/stl/crossbar_B_x2.stl

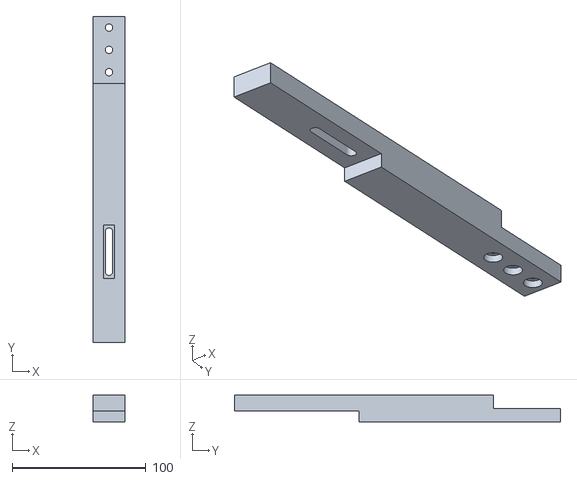
[picture p34: CAD file, 2026-11-08]
virus_ti/stl/crossbar_B_x2.stl
24.0 x 244.0 x 20.0
