raffaelerasini/stand-generator/virus_ti/stl/prop_x2.stl

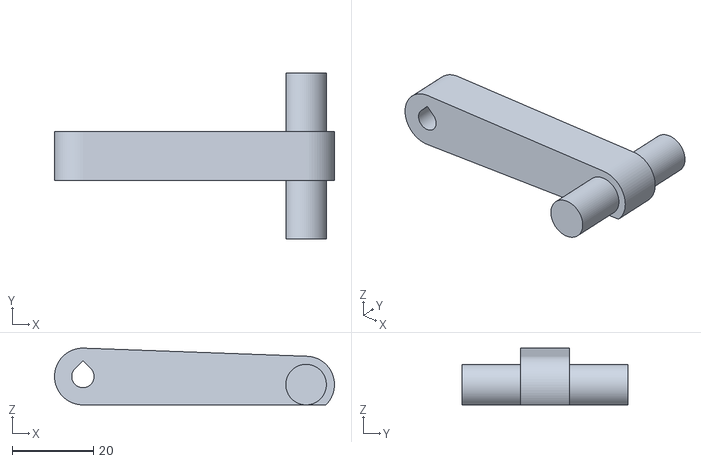
[picture p35: CAD file, 2026-11-08]
virus_ti/stl/prop_x2.stl
69.0 x 41.0 x 14.0
