raffaelerasini/stand-generator/(list of files, cad)

Other CAD files:
launchpad_pro/stl/crossbar_x2.stl
virus_ti/stl/crossbar_A_x2.stl
