raffaelerasini/stand-generator/launchpad_pro/montaggio.md

# Montaggio

## Ferramenta (per un supporto completo)

- 2× Vite M5×50 testa esagonale (DIN 933) — cerniera
- 4× Dado M5 autobloccante — cerniera, perno asta
- 2× Vite M5×40 testa esagonale (DIN 933) — perno asta
- 10× Rondella M5 5×10 — cerniera, perno asta, traverse
- 4× Vite M5×16 brugola (DIN 912) — traverse
- 4× Dado M5 — traverse

## Passi

1. **Basi.** Infila le due traverse nei tunnel delle basi (centro e retro). Nelle alette interne: dado nel canale sotto la traversa, vite M5×16 con rondella dall'alto. Le asole regolano la distanza tra i fianchi: 160–200 mm.
2. **Ripiano.** Infilalo davanti tra le pareti della base e fissalo con la vite M5×50 (rondella sotto la testa) e il dado autobloccante, incassato nella sede esagonale sul lato esterno della parete.
3. **Asta.** Inseriscila nella forcella sul retro del ripiano e fissala con la vite M5×40, due rondelle e il dado autobloccante. Le orecchie del piede si appoggiano nelle tacche.
4. **Cambio angolo.** Solleva il retro dello strumento, sposta il piede nella tacca voluta e riabbassa. Tacche dalla più avanti alla più indietro: 15°, 10°, 5°.
