raffaelerasini/stand-generator/virus_ti/montaggio.md

# Montaggio

## Ferramenta (per un supporto completo)

- 2× Vite M5×50 testa esagonale (DIN 933) — cerniera
- 4× Dado M5 autobloccante — cerniera, perno asta
- 2× Vite M5×40 testa esagonale (DIN 933) — perno asta
- 10× Rondella M5 5×10 — cerniera, perno asta, traverse
- 4× Vite M5×20 brugola (DIN 912) — traverse
- 10× Dado M5 — traverse, giunzione traverse
- 6× Vite M5×16 brugola (DIN 912) — giunzione traverse

## Passi

1. **Traverse.** Unisci le metà A e B nella zona a mezzo legno con 3 viti M5×16 per traversa: i dadi nelle sedi esagonali sotto A, le teste nelle lamature sopra B.
2. **Basi.** Infila le due traverse nei tunnel delle basi (centro e retro). Nelle alette interne: dado nel canale sotto la traversa, vite M5×20 con rondella dall'alto. Le asole regolano la distanza tra i fianchi: 330–390 mm.
3. **Ripiano.** Infilalo davanti tra le pareti della base e fissalo con la vite M5×50 (rondella sotto la testa) e il dado autobloccante, incassato nella sede esagonale sul lato esterno della parete.
4. **Asta.** Inseriscila nella forcella sul retro del ripiano e fissala con la vite M5×40, due rondelle e il dado autobloccante. Le orecchie del piede si appoggiano nelle tacche.
5. **Cambio angolo.** Solleva il retro dello strumento, sposta il piede nella tacca voluta e riabbassa. Tacche dalla più avanti alla più indietro: 45°, 35°, 25°, 15°.
