raffaelerasini/stand-generator/launchpad_pro/preview/assemblaggio.png

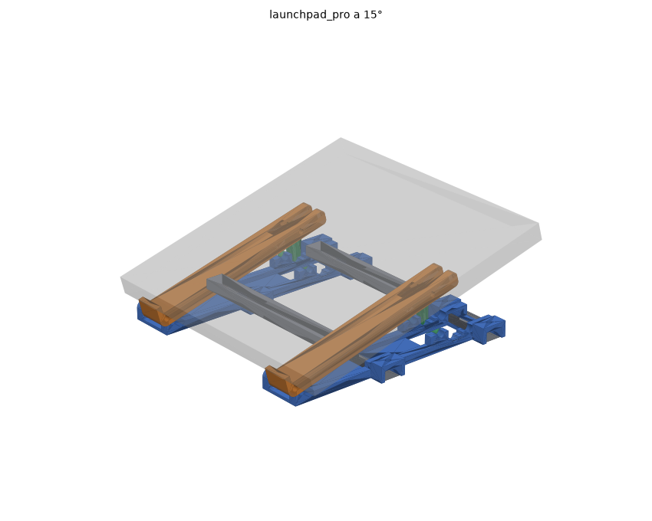
launchpad_pro/preview/assemblaggio.png
