raffaelerasini/stand-generator/tracker_plus/preview/assemblaggio.png

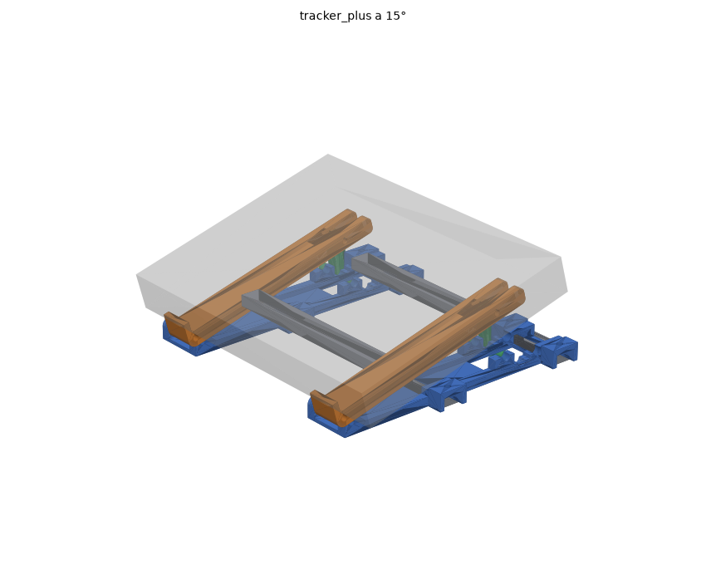
tracker_plus/preview/assemblaggio.png
