raffaelerasini/stand-generator/virus_ti/preview/assemblaggio.png

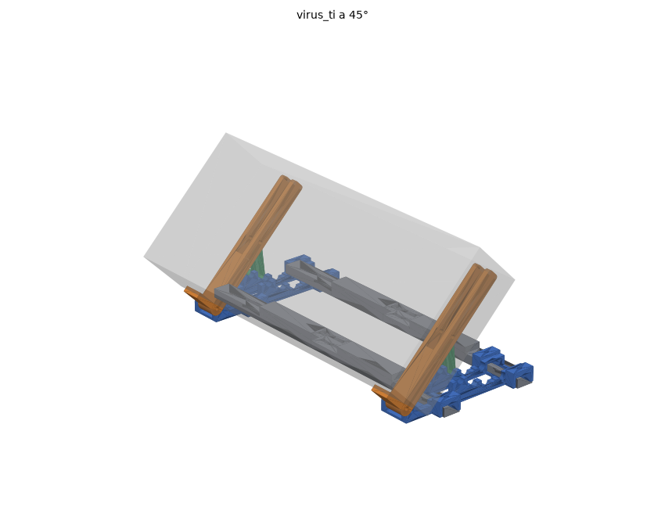
virus_ti/preview/assemblaggio.png
