raffaelerasini/stand-generator/launchpad_pro/verifica.md

# Verifica: launchpad_pro

**Esito: OK**

- ✅ **Viti** — tutte le viti sono nel catalogo standard: cerniera M5×50, perno M5×40, traverse M5×16
- ✅ **Tacche** — distanza tra tacche ≥ 14.6 mm: minima 16.6 mm
- ✅ **Tacche** — materiale sotto le tacche ≥ 3 mm: minimo 3.7 mm
- ✅ **Tacche** — asta inclinata tra 20° e 85°
- ✅ **Collisioni** — 5°: nessuna
- ✅ **Collisioni** — 10°: nessuna
- ✅ **Collisioni** — 15°: nessuna
- ✅ **Collisioni** — traverse nei tunnel delle basi
- ✅ **Pezzi** — base_x2: 228×72×18 mm
- ✅ **Pezzi** — deck_x2: 197×27×22 mm
- ✅ **Pezzi** — prop_x2: 47×40×12 mm
- ✅ **Pezzi** — crossbar_x2: 18×248×10 mm
- ✅ **Stabilità** — baricentro dentro l'appoggio: a 15° è 130 mm dietro il bordo anteriore
- ✅ **Stabilità** — margine anti-ribaltamento ≥ 15 mm: 130 mm a 15°
- ✅ **Scorta** — ferramenta disponibile nella scorta
