raffaelerasini/stand-generator/virus_ti/verifica.md

# Verifica: virus_ti

**Esito: OK**

- ✅ **Viti** — tutte le viti sono nel catalogo standard: cerniera M5×50, perno M5×40, traverse M5×20, giunzione M5×16
- ✅ **Tacche** — distanza tra tacche ≥ 16.6 mm: minima 22.2 mm
- ✅ **Tacche** — materiale sotto le tacche ≥ 3 mm: minimo 4.7 mm
- ✅ **Tacche** — asta inclinata tra 20° e 85°
- ✅ **Collisioni** — 15°: nessuna
- ✅ **Collisioni** — 25°: nessuna
- ✅ **Collisioni** — 35°: nessuna
- ✅ **Collisioni** — 45°: nessuna
- ✅ **Collisioni** — traverse nei tunnel delle basi
- ✅ **Pezzi** — base_x2: 190×72×29 mm
- ✅ **Pezzi** — deck_x2: 199×27×48 mm
- ✅ **Pezzi** — prop_x2: 69×41×14 mm
- ✅ **Pezzi** — crossbar_A_x2: 24×244×20 mm
- ✅ **Pezzi** — crossbar_B_x2: 24×244×20 mm
- ✅ **Stabilità** — baricentro dentro l'appoggio: a 45° è 42 mm dietro il bordo anteriore
- ✅ **Stabilità** — margine anti-ribaltamento ≥ 15 mm: 42 mm a 45°
- ✅ **Scorta** — ferramenta disponibile nella scorta
