raffaelerasini/stand-generator/(commit log)

2026-11-08 Refactor code structure for improved readability and maintainability
    [base_x2.stl, crossbar_A_x2.stl, crossbar_B_x2.stl, crossbar_x2.stl, deck_x2.stl, prop_x2.stl]
2026-11-08 Aggiorna le dimensioni del lip e modifica le specifiche nel README; aggiorna le immagini e i file STL per il supporto inclinabile
    [deck_x2.stl]
2026-11-08 Aggiorna le specifiche delle viti nel README, aggiungi nuovi parametri nel codice e sostituisci le immagini e i file STL per i supporti inclinabili
    [base_x2.stl]
2026-11-08 Aggiungi un nuovo modulo cadlib.py con funzioni geometriche comuni per i supporti
    [base_x2.stl, ferramenta.csv]
2026-11-08 Aggiungi il sito Gradio e il Docker Compose per Coolify
    - app.py: interfaccia web sopra standgen (visore 3D per angolo, anteprime,
    pezzi, ferramenta, montaggio, verifica, zip), cache dei risultati,
    coda con concorrenza limitata, password facoltativa (APP_PASSWORD)
    - Dockerfile, docker-compose.yml (Coolify) e override locale con la porta
    - tune: "1 prova" al singolare
2026-11-08 README: cartella base di Coolify è la radice del repository
2026-11-08 Aggiungi le istruzioni di montaggio illustrate (PDF stile IKEA)
    - drawing.py: rasterizzatore ortografico z-buffer in numpy; le linee nascono da
    contorni, pieghe e confini tra pezzi, quindi niente linee nascoste; viteria 3D
    - ikea.py: copertina, pezzi stampati, ferramenta in scala 1:1 con righello,
    passi esplosi con frecce, riquadri della ferramenta e dettagli ingranditi,
    pagina del cambio angolo
    - pipeline/CLI: istruzioni.pdf generato con i profili (--no-pdf per saltarlo);
    add_instructions per crearlo su richiesta e aggiungerlo allo zip
    - sito: pulsante nella scheda Montaggio con PDF e anteprima delle pagine
    - render: lock su pyplot, che non è thread-safe
    - test del PDF; istruzioni.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
2026-11-08 Sostituisci Gradio con l'interfaccia STAND (HTML/CSS/JS + FastAPI)
    - static/: interfaccia senza framework in stile blueprint scuro, con
    configuratore, visore 3D WebGL2 fatto in casa, profili per angolo,
    pezzi e ferramenta, montaggio pagina per pagina, verifica e layout mobile
    - app.py: API FastAPI con lavori in coda, avanzamento, cache su disco,
    disegni e mesh creati alla prima richiesta, protezione opzionale
    - standgen/blueprint.py: disegni chiari su fondo trasparente e mesh con
    spigoli vivi per il browser
    - Docker: niente Gradio, healthcheck su /healthz; test per mesh e parametri
2026-11-08 README: correggi il riferimento al sito e sposta la nota sulla traversa centrale
2026-11-08 Aggiungi i preset di Sinclair, Atari, Amstrad, BBC Micro e TI-99/4A
2026-11-08 Aggiungi 26 preset di desktop synth, groovebox e controller e riorganizza i gruppi
